gztproject/BikeSignal/PCB/BikeCommunicator.png

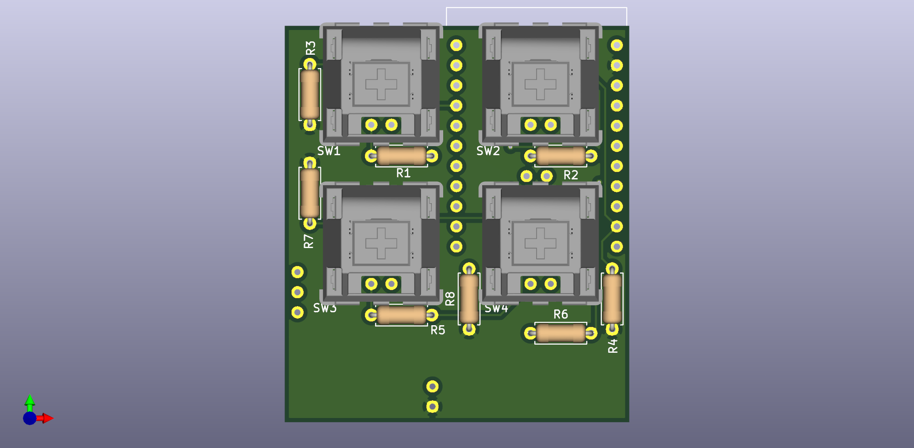
PCB/BikeCommunicator.png
