gztproject/BikeSignal/Housing/asm_mx_asm_PLATE.stp

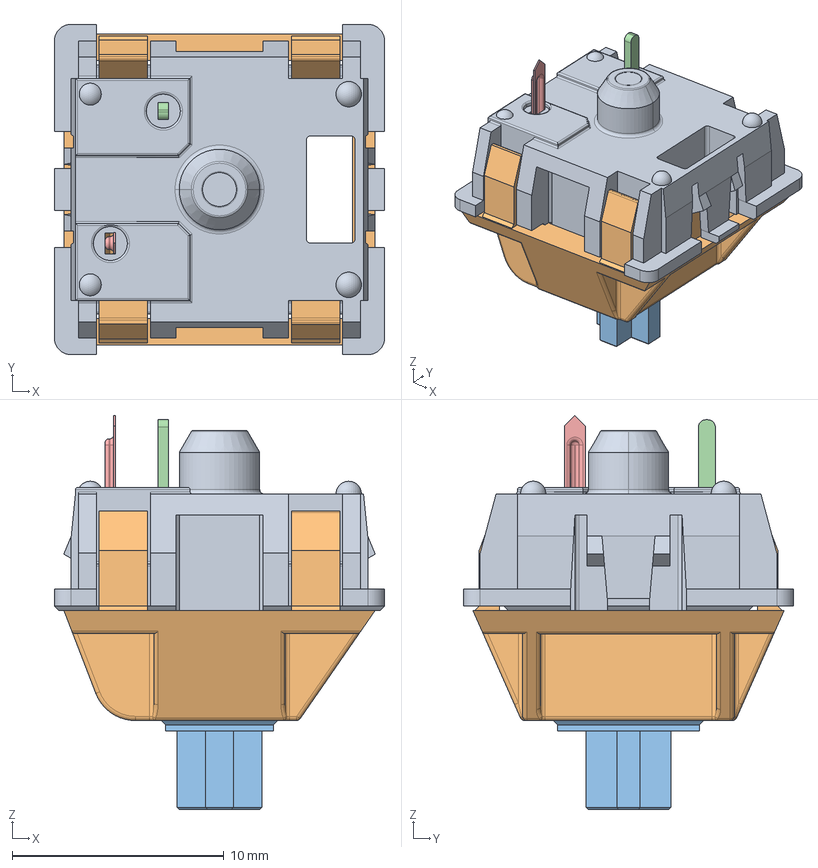
[picture p2: CAD file, 2020-06-09]
Housing/asm_mx_asm_PLATE.stp
15.6 x 15.6 x 18.6 mm
MX_DOWN
MX_UP
UP_MX
MX_PIN
MX_SPRING
MX_CLICK
