gztproject/BikeSignal/Housing/Cover_handlebar.3mf

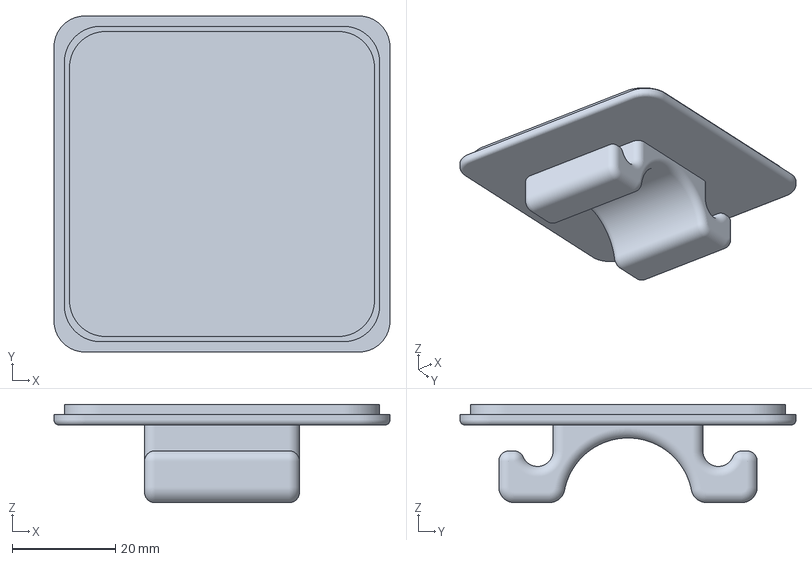
[picture p3: CAD file, 2020-06-14]
Housing/Cover_handlebar.3mf
65.0 x 65.0 x 19.0 mm
