gztproject/BikeSignal/Housing/Cover_PCB.stl

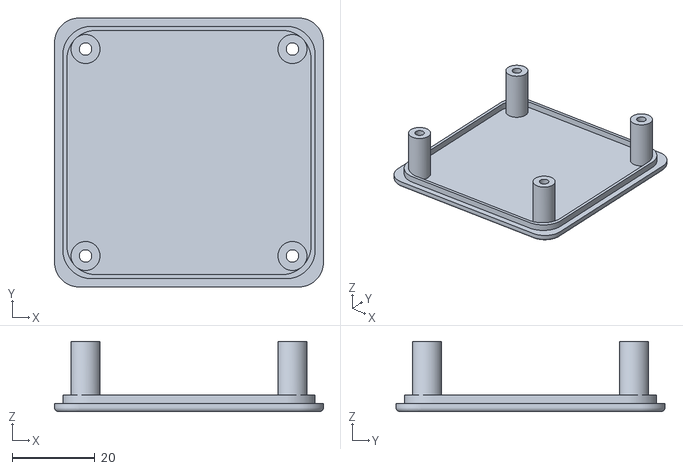
[picture p4: CAD file, 2020-06-14]
Housing/Cover_PCB.stl
65.0 x 65.0 x 17.0
