gztproject/BikeSignal/Housing/Cover_handlebar_PCB.stl

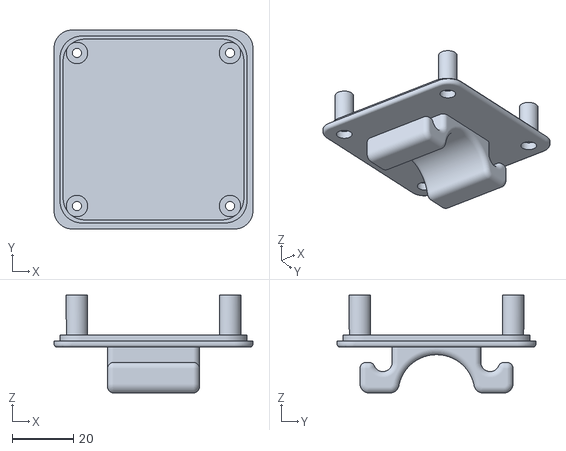
[picture p5: CAD file, 2020-06-14]
Housing/Cover_handlebar_PCB.stl
65.0 x 65.0 x 32.0
