gztproject/BikeSignal/Housing/Body.3mf

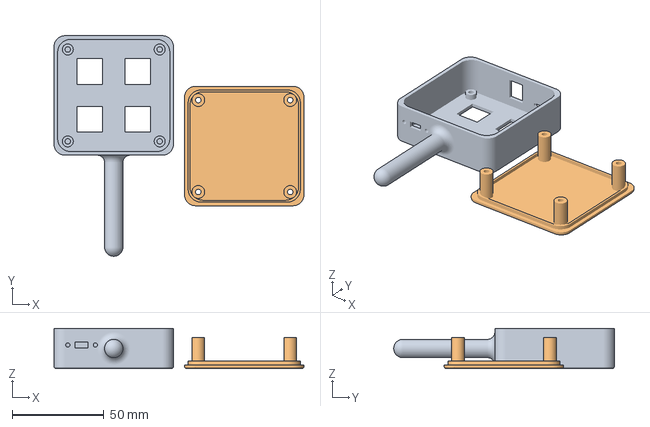
[picture p6: CAD file, 2020-06-12]
Housing/Body.3mf
136.0 x 120.0 x 21.8 mm
Body.stl
Cover.stl
