gztproject/BikeSignal/Housing/Cover.3mf

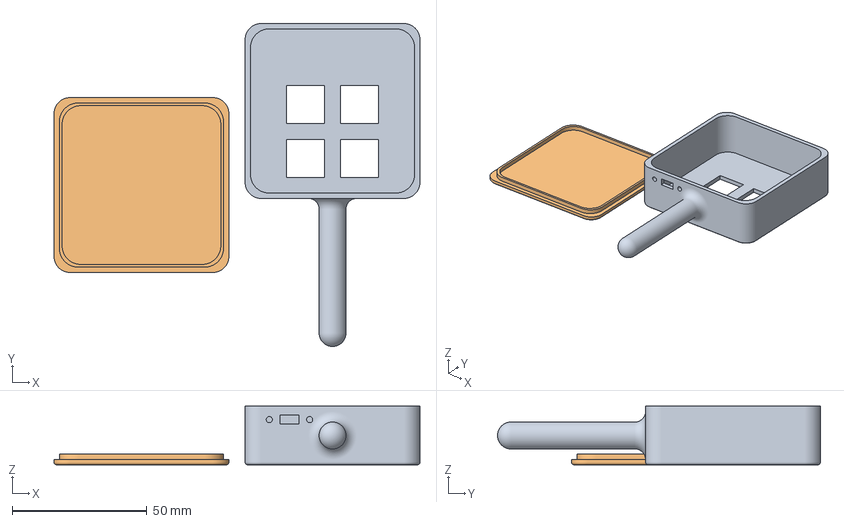
[picture p7: CAD file, 2020-06-09]
Housing/Cover.3mf
136.0 x 120.0 x 21.8 mm
Body.stl
Cover.stl
