gztproject/BikeSignal/(list of files, cad)

Other CAD files:
Housing/Housing.FCStd
Housing/Body.stl
Housing/Cover.stl
Housing/Cover_handlebar.stl
