gztproject/BikeSignal/PCB/BikeCommunicator.kicad_pcb

## KiCad design PCB/BikeCommunicator.kicad_pcb (2020-11-04)

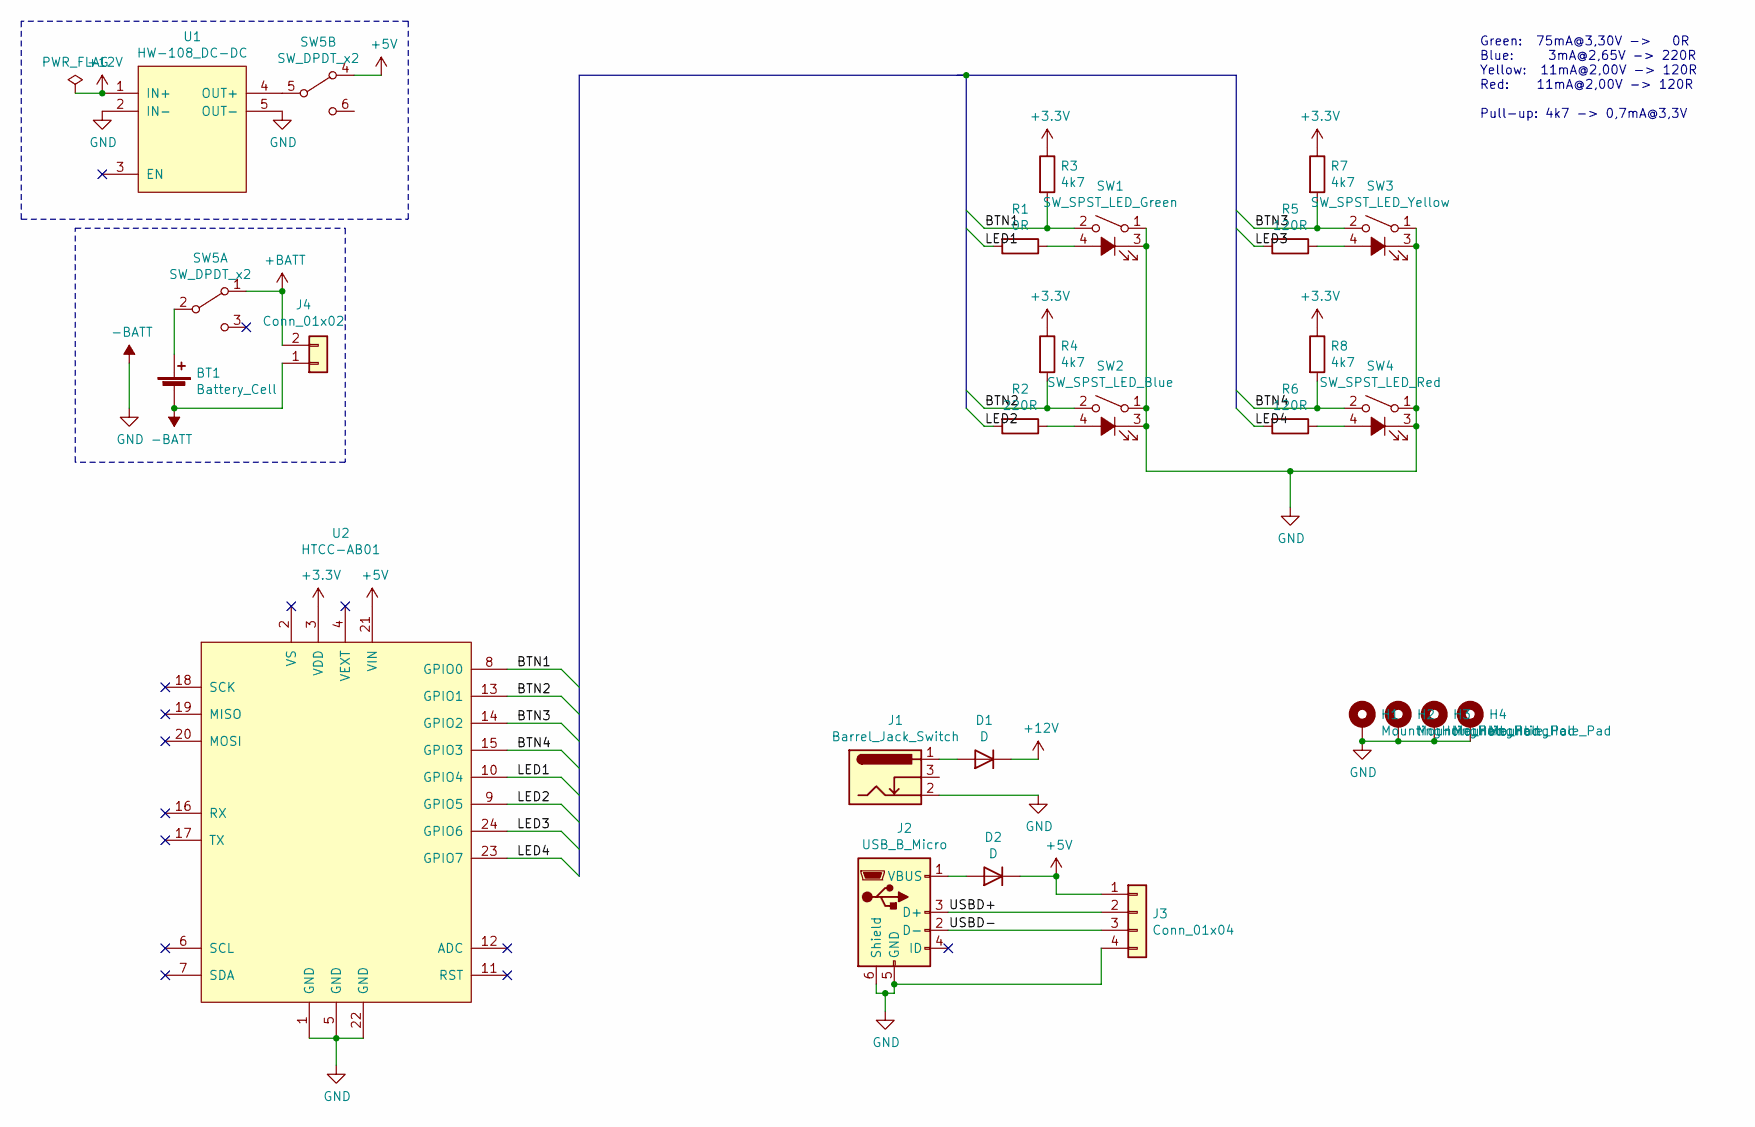
[picture p8: schematic BikeCommunicator.sch]

Parts:
BT1: Battery_Cell; SolderWirePad_1x02_P3.81mm_Drill1mm
D1, D2: D; D_SMA
H1, H2, H3, H4: MountingHole_Pad; MountingHole_3.2mm_M3_Pad_Via
J1: Barrel_Jack_Switch; BARREL_JACK
J2: USB_B_Micro; USB_Micro-B_Molex-105017-0001
J3: Conn_01x04; SolderWirePad_1x04_P3.81mm_Drill1mm
J4: Conn_01x02; SolderWirePad_1x02_P3.81mm_Drill1mm
R1: 0R; R_1206
R2: 220R; R_1206
R3, R4, R7, R8: 4k7; R_1206
R5, R6: 120R; R_1206
SW1: SW_SPST_LED_Green; SW_Cherry_MX1A_LED_1.00u_PCB
SW2: SW_SPST_LED_Blue; SW_Cherry_MX1A_LED_1.00u_PCB
SW3: SW_SPST_LED_Yellow; SW_Cherry_MX1A_LED_1.00u_PCB
SW4: SW_SPST_LED_Red; SW_Cherry_MX1A_LED_1.00u_PCB
SW5: SW_DPDT_x2; SW_CuK_JS202011AQN_DPDT_Angled
U1: HW-108_DC-DC; HW-108
U2: HTCC-AB01

Connections:
+3V3: R3.1, R4.1, R7.1, R8.1, U2.3 (VDD)
+5V: D2.1 (K), J3.1, SW5.4 (A), U2.21 (VIN)
+12V: D1.1 (K), U1.1 (IN+)
+BATT: J4.2, SW5.1 (A)
-BATT: BT1.2 (-), H1.1, H2.1, H3.1, H4.1, J1.2, J2.5 (GND), J2.6 (Shield), J3.4, J4.1, SW1.1, SW1.3 (K), SW2.1, SW2.3 (K), SW3.1, SW3.3 (K), SW4.1, SW4.3 (K), U1.2 (IN-), U1.5 (OUT-), U2.1 (GND), U2.5 (GND), U2.22 (GND)
/BTN1: R3.2, SW1.2, U2.8 (GPIO0)
/BTN2: R4.2, SW2.2, U2.13 (GPIO1)
/BTN3: R7.2, SW3.2, U2.14 (GPIO2)
/BTN4: R8.2, SW4.2, U2.15 (GPIO3)
/LED1: R1.2, U2.10 (GPIO4)
/LED2: R2.2, U2.9 (GPIO5)
/LED3: R5.2, U2.24 (GPIO6)
/LED4: R6.2, U2.23 (GPIO7)
/USBD+: J2.3 (D+), J3.2
/USBD-: J2.2 (D-), J3.3
unnamed: BT1.1 (+), SW5.2 (B)
unnamed: D1.2 (A), J1.1
unnamed: D2.2 (A), J2.1 (VBUS)
unnamed: R1.1, SW1.4 (A)
unnamed: R2.1, SW2.4 (A)
unnamed: R5.1, SW3.4 (A)
unnamed: R6.1, SW4.4 (A)
unnamed: SW5.5 (B), U1.4 (OUT+)

Notes on the sheet:
Green: 75mA@3,30V -> 0R Blue: 3mA@2,65V -> 220R Yellow: 11mA@2,00V -> 120R Red: 11mA@2,00V -> 120R Pull-up: 4k7 -> 0,7mA@3,3V

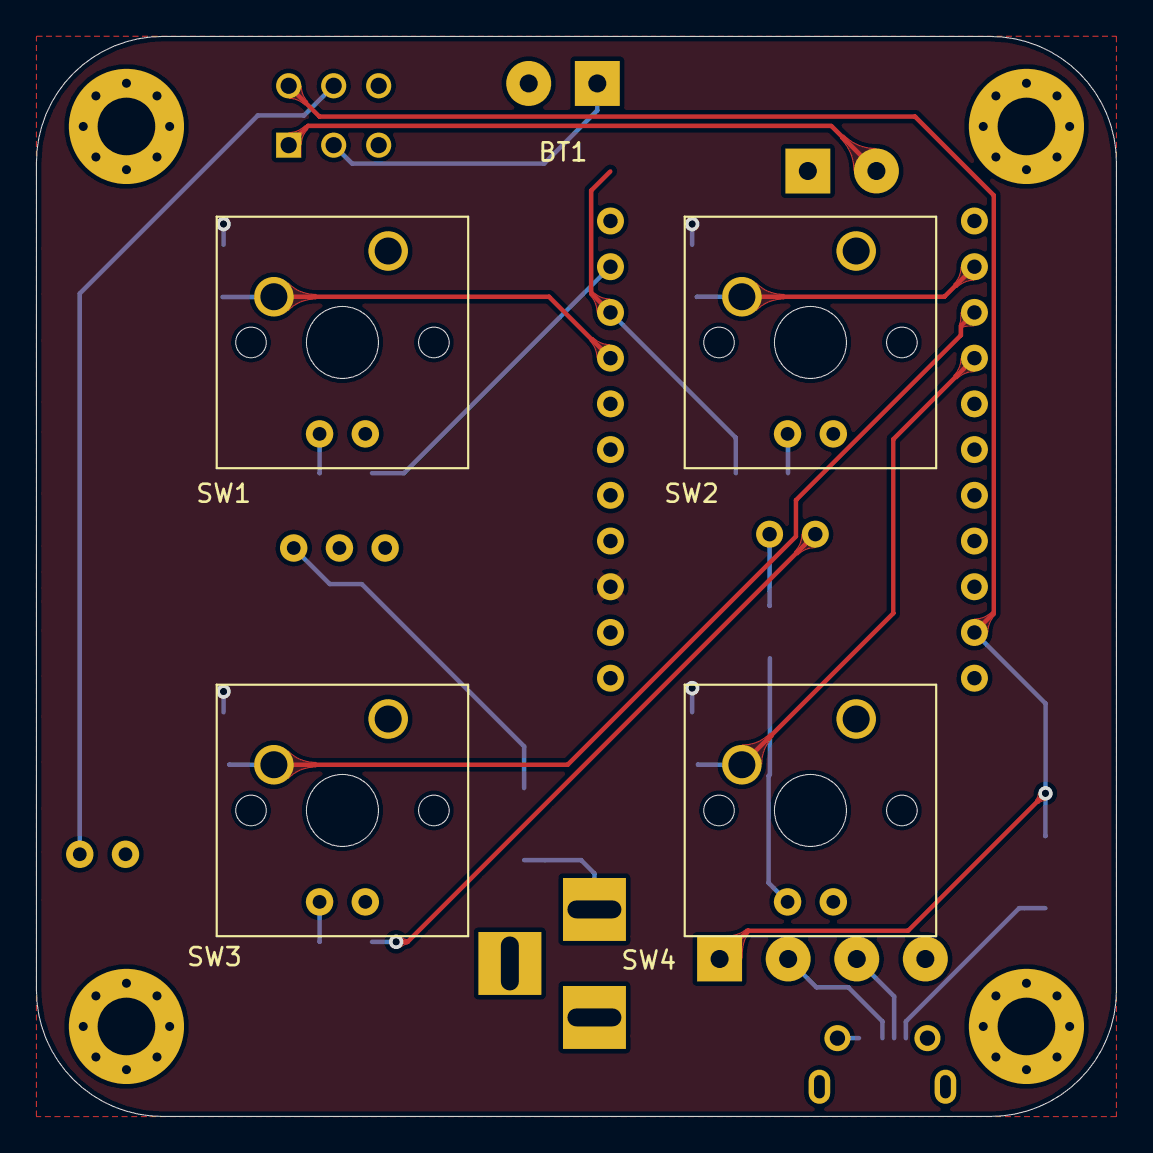
[picture p9: board BikeCommunicator.kicad_pcb from above]

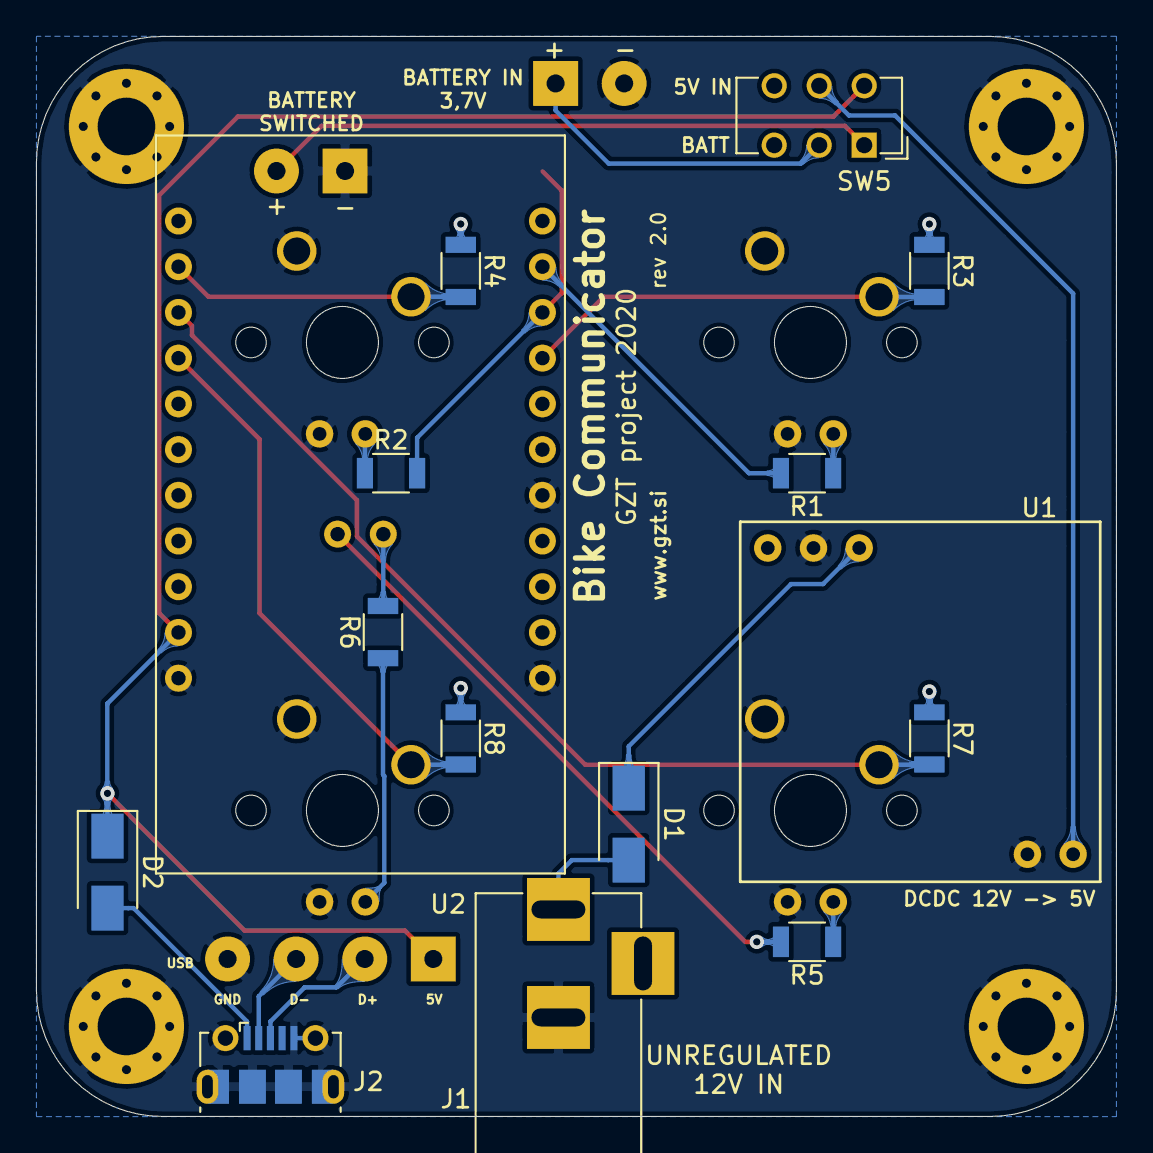
[picture p10: board BikeCommunicator.kicad_pcb from below]

Board: 2 copper layers, 60.0 x 60.0 mm, 26 parts (16 on the bottom side), 23 nets.
