gztproject/BikeSignal/Housing/Assembly.pdf

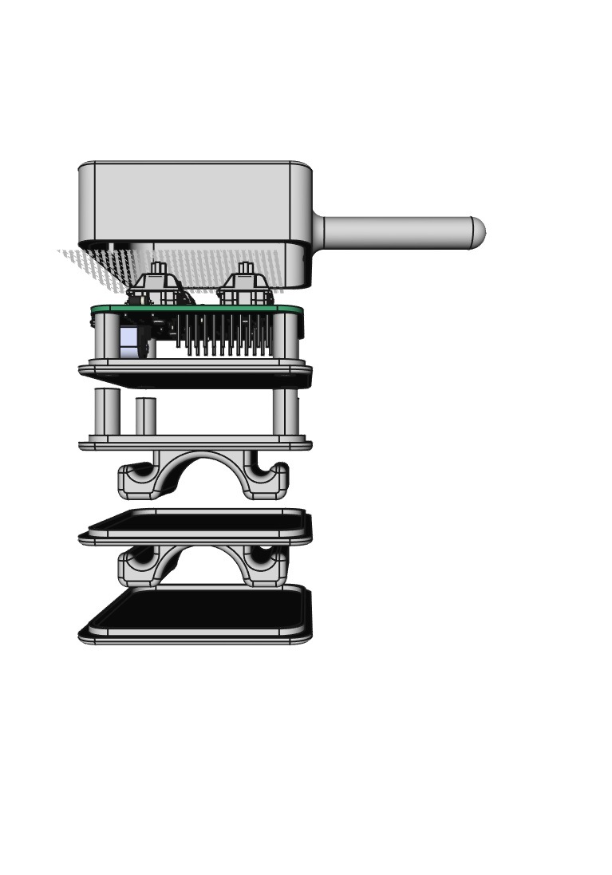
[picture p11: page 1]
