gztproject/BikeSignal/(commit log)

2020-06-09 Added existing files
    [BikeCommunicator-B_Cu.gbr, BikeCommunicator-B_Mask.gbr, BikeCommunicator-B_Paste.gbr, BikeCommunicator-B_SilkS.gbr, BikeCommunicator-Edge_Cuts.gbr, BikeCommunicator-F_Cu.gbr, BikeCommunicator-F_Mask.gbr, BikeCommunicator-F_Paste.gbr]
2020-06-09 Fixed various errors.
    [Cover.3mf]
2020-06-09 Added panel support for 4 buttons and LEDs
2020-06-10 Added some more LED indications
2020-06-10 Fit PCB to housing, added some more elements to scheme
    [BikeCommunicator.kicad_pcb, BikeCommunicator.sch]
2020-06-11 Redesigned PCB and housing to fit it.
    [BikeCommunicator.kicad_pcb, BikeCommunicator.sch, Body.stl, Cover.stl, Housing.FCStd]
2020-06-11 Updated gerbers
    [BikeCommunicator-B_Cu.gbr, BikeCommunicator-B_Mask.gbr, BikeCommunicator-B_Paste.gbr, BikeCommunicator-B_SilkS.gbr, BikeCommunicator-Edge_Cuts.gbr, BikeCommunicator-F_Cu.gbr, BikeCommunicator-F_Mask.gbr, BikeCommunicator-F_Paste.gbr]
2020-06-12 Added Slicer file and PDF
    [Body.3mf]
2020-06-13 Added resistor values
    [BikeCommunicator.sch]
2020-06-13 A few more bugfixes
    [main.cpp]
2020-06-14 Updated PCB project file
    [BikeCommunicator.kicad_pcb]
2020-06-14 Updated the housing models
    [Cover.stl, Cover_PCB.stl, Cover_handlebar.stl, Cover_handlebar_PCB.stl, Housing.FCStd]
2020-06-14 Added more covers
    [Cover_handlebar.3mf]
2020-08-14 Major PCB fix
    [BikeCommunicator-B_Cu.gbr, BikeCommunicator-B_Mask.gbr, BikeCommunicator-B_Paste.gbr, BikeCommunicator-B_SilkS.gbr, BikeCommunicator-Edge_Cuts.gbr, BikeCommunicator-F_Cu.gbr, BikeCommunicator-F_Mask.gbr, BikeCommunicator-F_Paste.gbr]
2020-11-04 SMD components on PCB, fabrication files...
    [BikeCommunicator-B_Cu.gbr, BikeCommunicator-B_Mask.gbr, BikeCommunicator-B_Paste.gbr, BikeCommunicator-B_SilkS.gbr, BikeCommunicator-Edge_Cuts.gbr, BikeCommunicator-F_Cu.gbr, BikeCommunicator-F_Mask.gbr, BikeCommunicator-F_Paste.gbr]
